osefrance/AlphaSole-Automation/README.md

# AlphaSole-Automation
Automation system of AlphaSole solar linear fresnel concentrator
