osefrance/AlphaSole-Automation/AlphaSole-Automation/diapo_soutenance.pptx

## Projet industriel AlphaSole

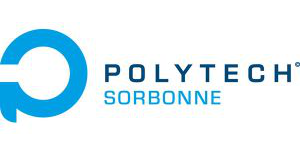
[picture p7: figure]
Résultat de recherche d'images pour "polytech sorbonne"

Automatisation d’un concentrateur solaire pour une optimisation de la gestion d’énergie

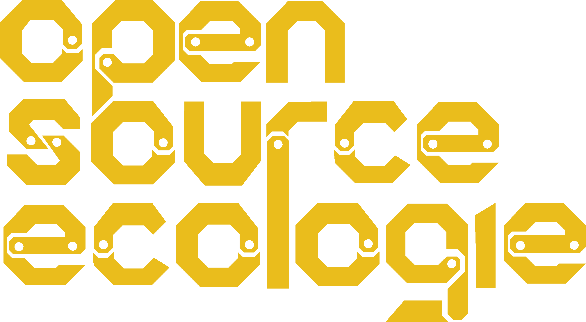
[picture p8: figure]
Résultat de recherche d'images pour "open source écologie"

Avec la participation de :
BOUNI Cyprien BESSIERES Fabien WEI Billy Liang GORET-QUENET François
Tuteur :
DARGA Arouna

## Motivation et contexte du project

Motivation et contexte

Demande du client

Solution proposée

Réalisation I

Réalisation II

Réalisation III

Réalisation IV

Ouverture I

Ouverture II

Future

Livrable

Page 1

Projet : Automatisation d’Alphasol

- Suivre la trajectoire du soleil

- Concentrateur Solaire Open Source & Cout moindre
- 5 kW => Utile pour micro-industries
- Besoin d’optimiser le rendement.

## Demande du Client

Motivation et contexte

Demande du client

Solution proposée

Réalisation I

Réalisation II

Réalisation III

Réalisation IV

Ouverture I

Ouverture II

Future

Livrable

P 1

Page 2

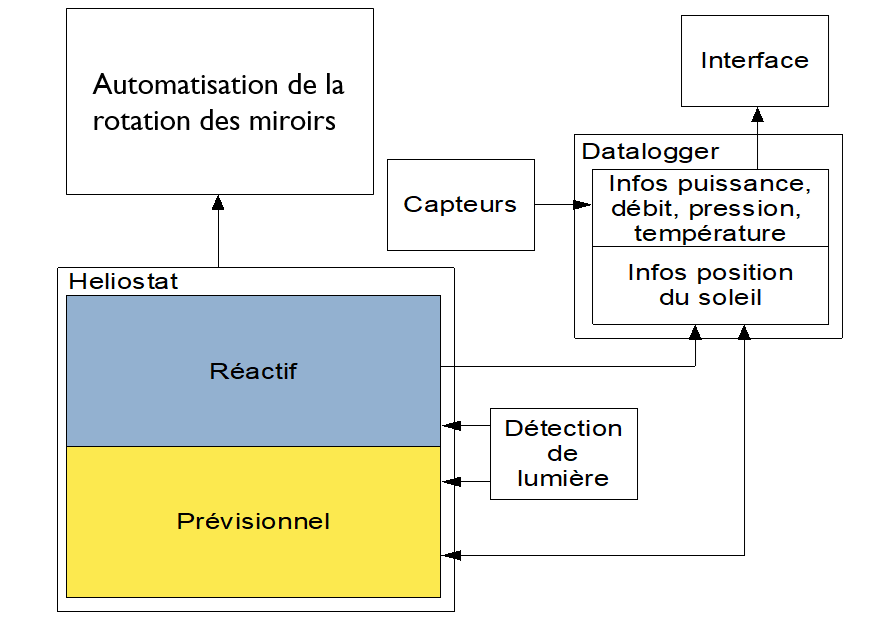
[picture p9: figure]

## Solution proposée

Motivation et contexte

Demande du client

Solution proposée

Réalisation I

Réalisation II

Réalisation III

Réalisation IV

Ouverture I

Ouverture II

Future

Livrable

Page 3

## Réalisation I : DATALOGGER

Motivation et contexte

Demande du client

Solution proposée

Réalisation I

Réalisation II

Réalisation III

Réalisation IV

Ouverture I

Ouverture II

Future

Livrable

Page 4

Rotation des miroirs

Informations de puissance & état du fluide

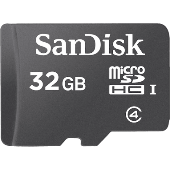
[picture p10: figure]
RÃ©sultat de recherche d'images pour "carte SD"

Mode réactif

Enregistrer le nombre de tour. Toutes les 5 min.

Enregistrer :
- Température
- Pression
- Débit
- Puissance

Mode prévisionnel

Lecture du nombre de tour. Toutes les 5 min.

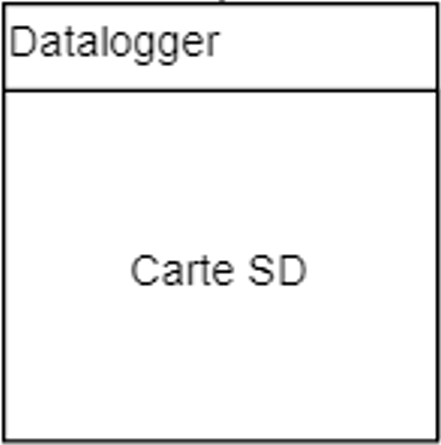
[picture p11: figure]

## Réalisation II : héliostat

Motivation et contexte

Demande du client

Solution proposée

Réalisation I

Réalisation II

Réalisation III

Réalisation IV

Ouverture I

Ouverture II

Future

Livrable

Page 5

Suivi Réactif

Photodiode
+
Luxmètre

Suivi Prévisionnel

Datalogger
+
Luxmètre

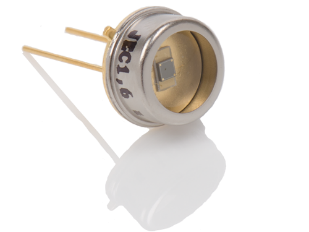
[picture p12: figure]
RÃ©sultat de recherche d'images pour "photodiode"
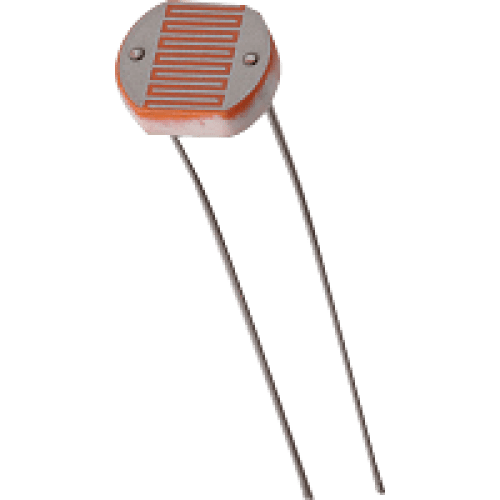
[picture p13: figure]
RÃ©sultat de recherche d'images pour "photorÃ©sistance"
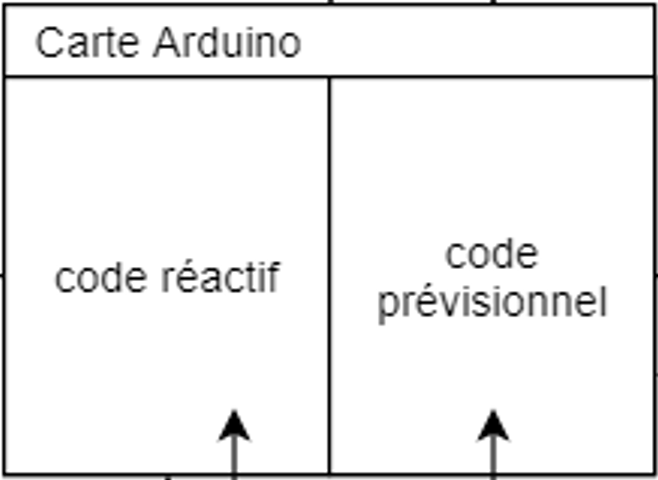
[picture p14: figure]

## Réalisation III : Automatisation

Motivation et contexte

Demande du client

Solution proposée

Réalisation I

Réalisation II

Réalisation III

Réalisation IV

Ouverture I

Ouverture II

Future

Livrable

Page 6

Rotation des miroirs

Moteur
+
Shield Arduino

Connaitre la position des miroirs

Compte tours

Photo
interrupteur

+
Capteur butée

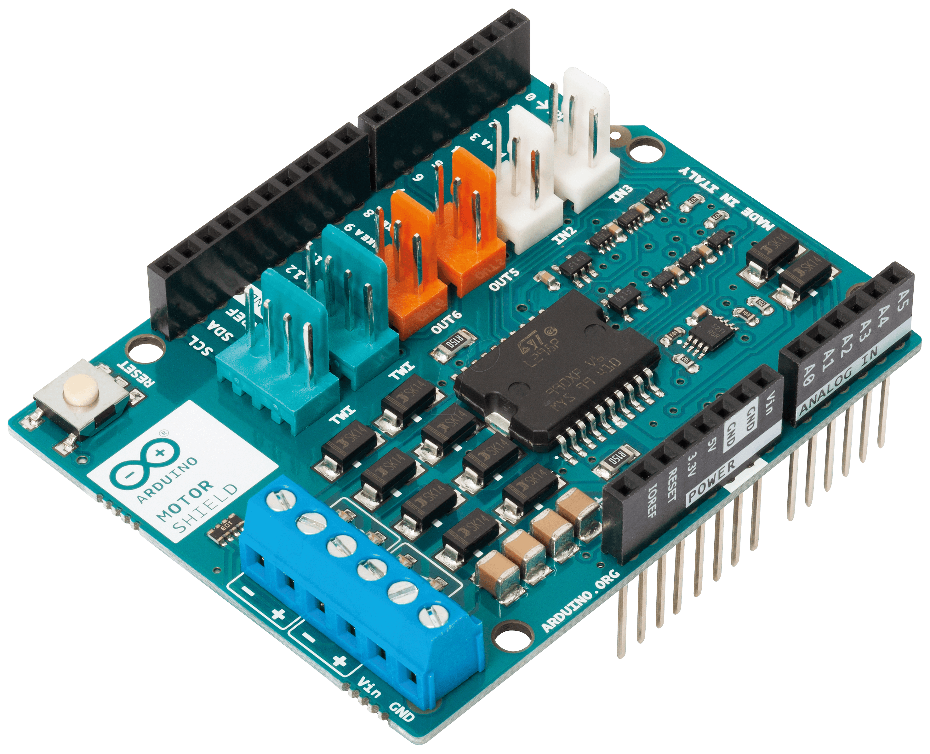
[picture p15: figure]
RÃ©sultat de recherche d'images pour "motor shield arduino"
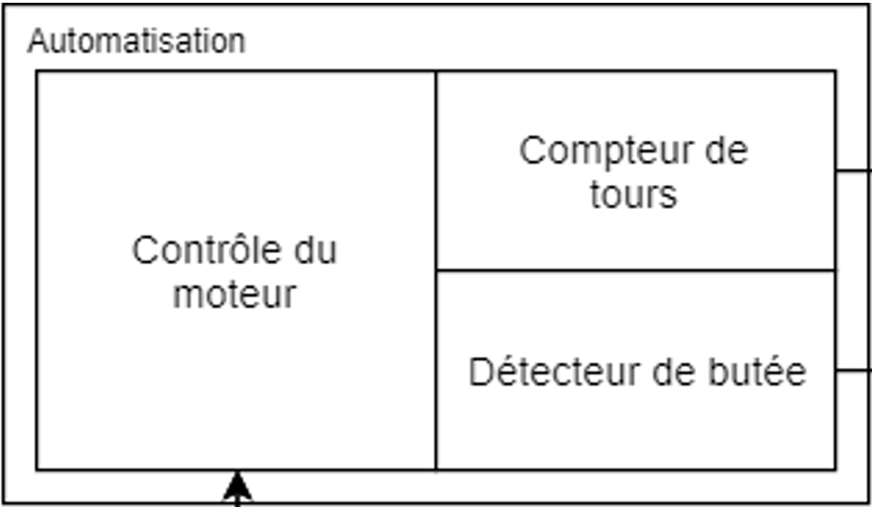
[picture p16: figure]

## Réalisation IV : Interface

Motivation et contexte

Demande du client

Solution proposée

Réalisation I

Réalisation II

Réalisation III

Réalisation IV

Ouverture I

Ouverture II

Future

Livrable

Page 7

Face

Boite

Capteur débit

Température

Débit

Pression

Bug

Capteur pression

ON/OFF

Etat urgence

Pile 9V

Réactif

Prévisionnel

Power

Lux

Capteur température

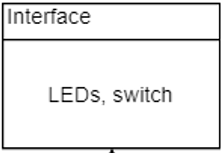
[picture p17: figure]

SD

## Les livrables

Motivation et contexte

Demande du client

Solution proposée

Réalisation I

Réalisation II

Réalisation III

Réalisation IV

Ouverture I

Ouverture II

Future

Livrable

P 3

Page 8

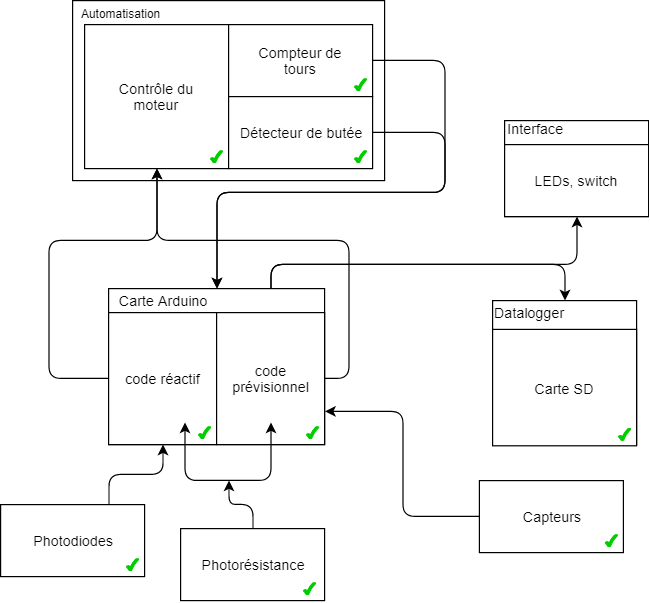
[picture p18: figure]

Tuyau

## Ouverture I : Apprentissage de management de projet

- Création d’un planning
- Relation client
- Création cahier des charges
- Binôme

Motivation et contexte

Demande du client

Solution proposée

Réalisation I

Réalisation II

Réalisation III

Réalisation IV

Ouverture I

Ouverture II

Future

Livrable

Page 9

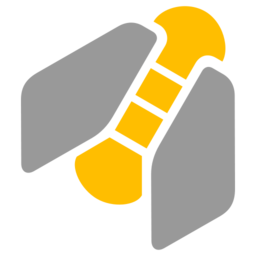
[picture p19: figure]
RÃ©sultat de recherche d'images pour "gantt project"
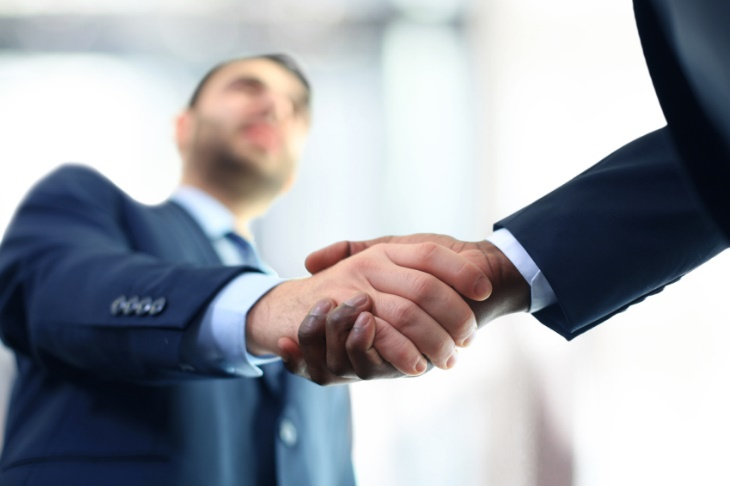
[picture p20: figure]
RÃ©sultat de recherche d'images pour "client"

## Ouverture II : Assurer la Pérennité du projet

Motivation et contexte

Demande du client

Solution proposée

Réalisation I

Réalisation II

Réalisation III

Réalisation IV

Ouverture I

Ouverture II

Future

Livrable

Page 10

- Schématisation des montages
- Documentation
- Archivage

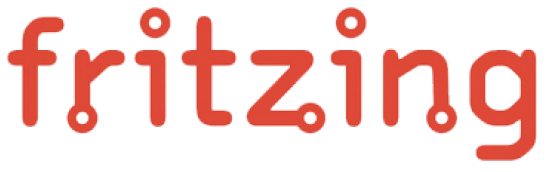
[picture p21: figure]
RÃ©sultat de recherche d'images pour "fritzing"
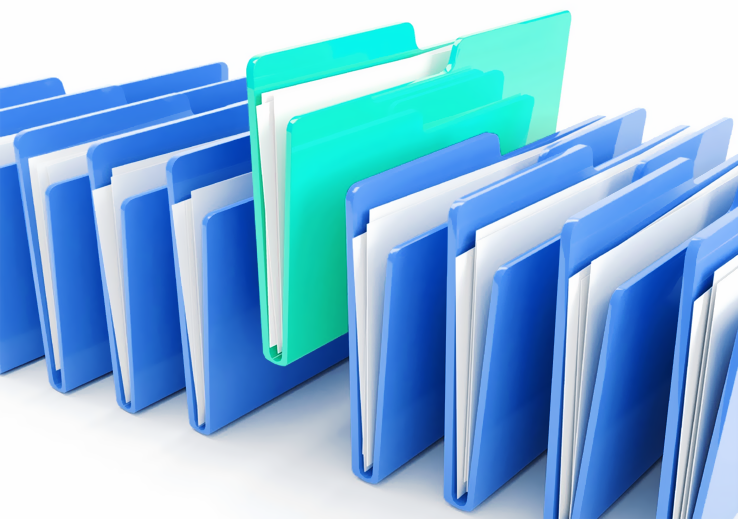
[picture p22: figure]
RÃ©sultat de recherche d'images pour "documentation"

## PROJETS Future

Motivation et contexte

Demande du client

Solution proposée

Réalisation I

Réalisation II

Réalisation III

Réalisation IV

Ouverture I

Ouverture II

Future

Livrable

Page 11

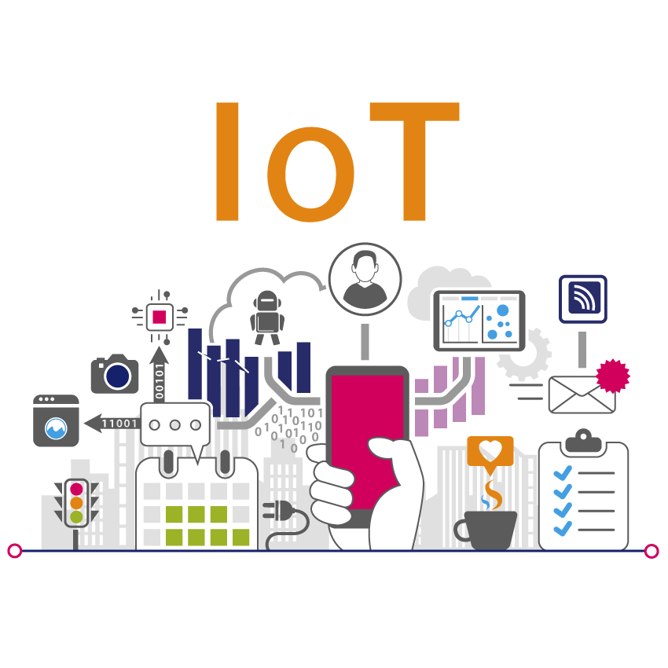
[picture p23: figure]
RÃ©sultat de recherche d'images pour "IoT"

- Module IoT
- Alimentation autonome
- Ajout tuyau de test
