osefrance/AlphaSole-Automation/AlphaSole-Automation/Retour sur expérience.docx

Retour sur expérience:

Dans le cadre de nos études nous avons été amenés à travailler en groupe de 4 sur un projet proposé par une entreprise ou association. Cette première expérience avec un véritable client nous a appris à améliorer notre communication. Nous avons dû faire un cahier des charges en commun avec notre client et aussi lui communiquer notre avancement régulièrement. Pour pouvoir respecter ce cahier des charges nous avons appris à répartir les tâches, calculer le temps de travaille en jour/homme, à utiliser Gantt pour faire notre planning et créer une matrice des risques pour faire un plan d’action.

Côté technique, nous avons été sollicités sur les parties électroniques et informatiques. Nous avons travaillé avec des nouveaux composants (les différents capteurs) et nous les avons adaptés pour qu'ils fonctionnent dans le cadre de notre projet. Cette adaptation s'est faite électroniquement mais aussi informatiquement, où par exemple avec le choix d'une résistance et un code adapté, on a pu se servir d'une photorésistance comme d'un luxmètre.

Pour le côté informatique, nous avons codé sur Arduino et avons développé les différents modules constituant le système entier, puis nous les avons intégrés un à un.
