osefrance/AlphaSole-Automation/AlphaSole-Automation/Documentation/DOC_datalogger.pdf

- 1 -

Alphasole - Documentation Datalogger

Intitulé | Datalogger
Documentation | Technique
Date | 23/05/2018
Version | 1.4
Auteurs | BESSIERES Fabien, GORET-QUENET François, WEI Billy-Liang, BOUNI Cyprien


- 2 -

# 1 - Présentation & Fonctionnement

«Figure 1: Vue système»

Le datalogger a pour but, dans un premier temps, de récupérer les données des capteurs de pression, température, débit et de les enregistrer dans un fichier csv (compatible avec excel) dans la carte SD. Et dans un second temps,il doit récupérer les données sur la position du soleil lorsque l’héliostat est en mode réactif, grâce aux photodiodes. Ce module communique donc avec l’interface utilisateur qui doit utiliser les informations de puissances, débit, pression et température, ainsi qu’avec l’héliostat mode réactif car il récupère la position du soleil et

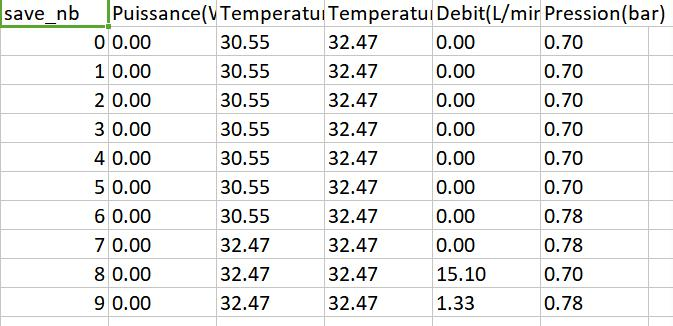
[picture p26: figure]

- 3 -

l’héliostat prévisionnel car il doit envoyer les valeurs sur la position du soleil. On précise que la carte SD doit être formatée en FAT16 ou FAT32, et est connecté par SPI à la

carte Arduino MEGA 2560.

«DAYX.csv : 1ere colonne : le numéro de capture»

«SUN.txt : 1ere colonne : le numéro de capture. 2eme colonne : la position des miroirs» A l’installation du système la carte SD doit contenir le fichier sun.txt. Ce fichier devra

comprendre 288 lignes (car en 1 jour, on fait 288 captures, à raison de 1 capture toutes les 5 minutes): La première colonne numérotée de 0 à 287, et la deuxième colonne comprendra uniquement -1 sur chaque ligne. Enfin, il faut bien mettre un retour chariot à la fin de la dernière ligne, sans cela il y a un risque d’erreurs.

- 4 -

# 2 - Fonctionnalités

Le fonctionnement du datalogger expliqué précédemment est écrit dans le fichier datalogger.ino

Datalogger.ino

Nom | Description | Entrées | Sorties
saveDatalogger | Enregistre dans le fichier «dayX.csv» (X le nombre de jour écoulé depuis le lancement) une capture contenant puissance, température des capteurs 1 et 2 et pression. | Rien | Rien
initDatalogger | Lors d’une nouvelle journée, la fonction va initialiser un nouveau fichier correspondant au jour. | Rien | Rien
refreshHeliostat | Enregistre dans le fichier «sun.txt» une capture moteur. contenant la position du | Rien | Rien
initHeliostat | Au début de la journée, on récupère les positions du moteur du jour précédent, et on le stock dans un tableau. | Rien | Rien

# Annexes
