osefrance/AlphaSole-Automation/(list of files, drawings)

Other design files:
AlphaSole-Automation/montage_total.fzz
