osefrance/AlphaSole-Automation/AlphaSole-Automation/Code V3/main/sleepModeControl.ino

/*
 * From
 * Donal Morrissey - 2011.
 * Modified
 */


/***************************************************
 *  Name:        ISR(WDT_vect)
 *
 *  Returns:     Nothing.
 *
 *  Parameters:  None.
 *
 *  Description: Watchdog Interrupt Service. This
 *               is executed when watchdog timed out.
 *
 ***************************************************/
ISR(WDT_vect)
{
  if(f_wdt == 0)
  {
    f_wdt=1; //Defined in solarContrator.h
  }
  else
  {
    //Serial.println("WDT Overrun!!!");
  }
}


/***************************************************
 *  Name:        enterSleep
 *
 *  Returns:     Nothing.
 *
 *  Parameters:  None.
 *
 *  Description: Enters the arduino into sleep mode.
 *
 ***************************************************/
void enterSleep(void)
{
  set_sleep_mode(SLEEP_MODE_IDLE);   /* EDIT: could also use SLEEP_MODE_PWR_DOWN for lowest power consumption. */
  sleep_enable();
  
  /* Now enter sleep mode. */
  sleep_mode();
  
  /* The program will continue from here after the WDT timeout*/
  sleep_disable(); /* First thing to do is disable sleep. */
  
  /* Re-enable the peripherals. */
  power_all_enable();
}



/***************************************************
 *  Name:        wdtInitialisation()
 *
 *  Returns:     Nothing.
 *
 *  Parameters:  None.
 *
 *  Description: Setup for the
 *                Watch dog timeout. 
 *
 ***************************************************/
void wdtInitialisation(){
  /* Clear the reset flag. */
  MCUSR &= ~(1<<WDRF);
  
  /* In order to change WDE or the prescaler, we need to
   * set WDCE (This will allow updates for 4 clock cycles).
   */
  WDTCSR |= (1<<WDCE) | (1<<WDE);

  /* set new watchdog timeout prescaler value */
  WDTCSR = 1<<WDP0 | 1<<WDP3; /* 8.0 seconds */
  
  /* Enable the WD interrupt (note no reset). */
  WDTCSR |= _BV(WDIE);
  Serial.println("Watchdog initialised");
}
